24ariel3/SmartInfo/EXTRA/Docs/18650_battery_shield_v8_schematic.pdf

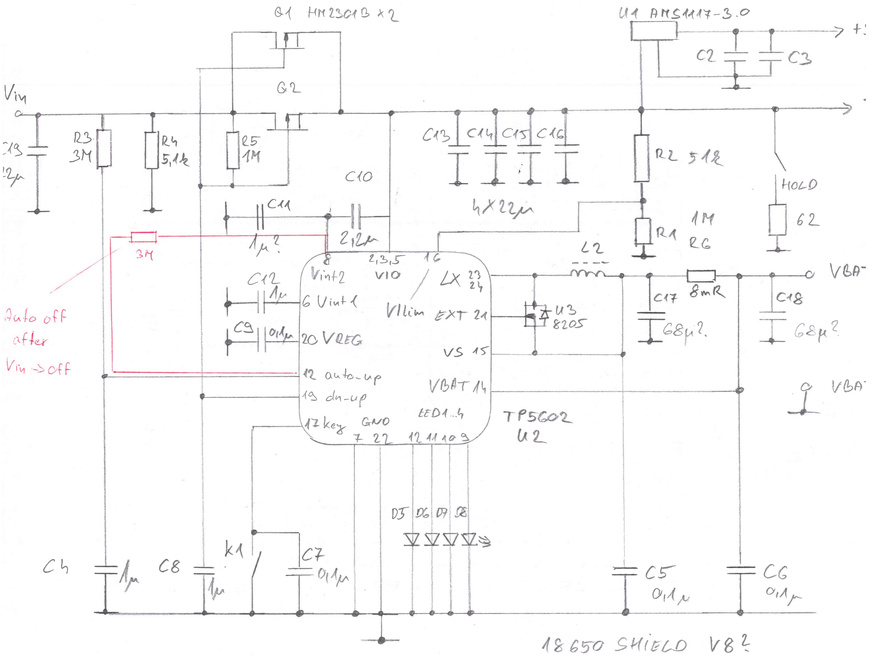
[picture p4: page 1]
