24ariel3/SmartInfo/EXTRA/Docs/18650_sheild.jpg

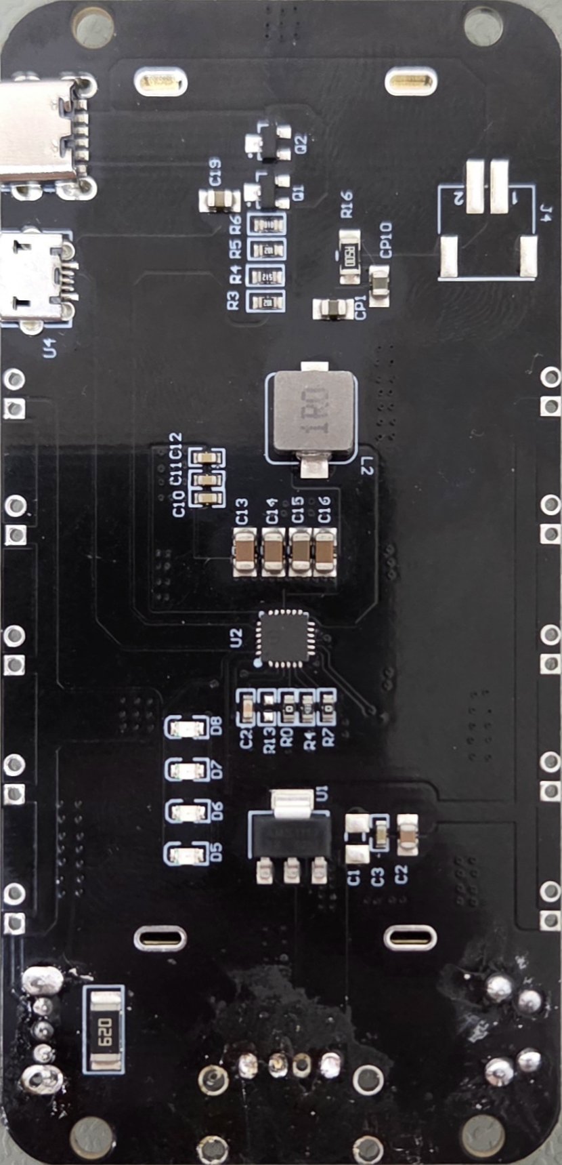
EXTRA/Docs/18650_sheild.jpg
