24ariel3/SmartInfo/EXTRA/Docs/18650_sheild_2.png

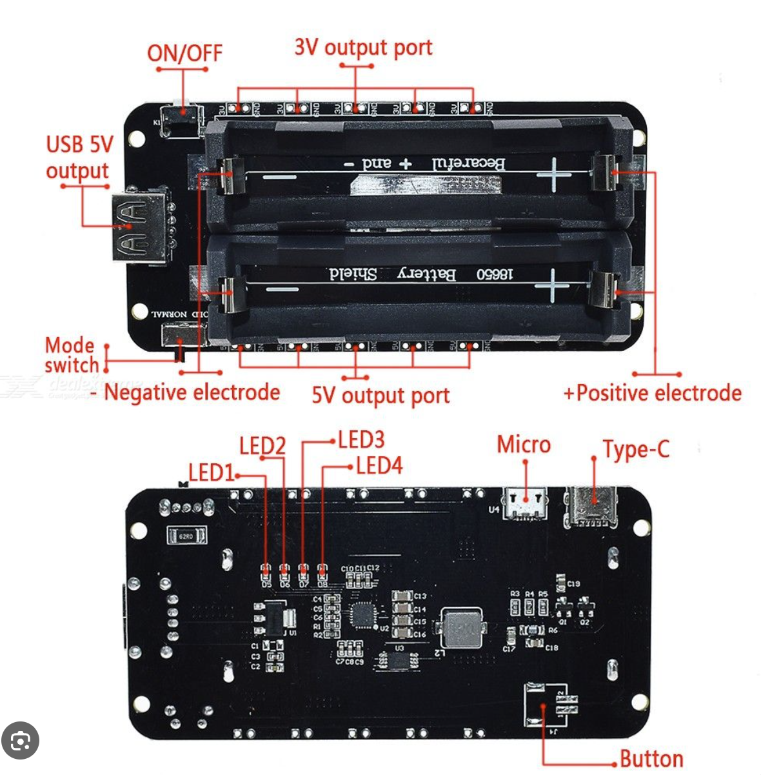
EXTRA/Docs/18650_sheild_2.png
