24ariel3/SmartInfo/EXTRA/Docs/18650_sheild_v3_schematic.jpeg

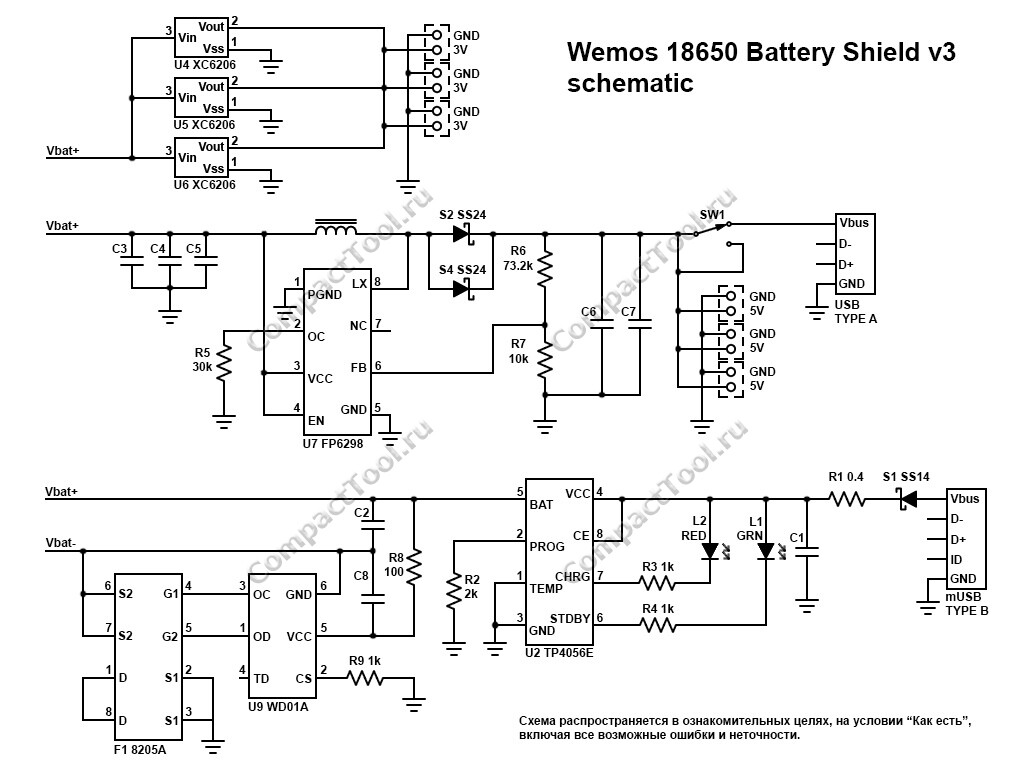
EXTRA/Docs/18650_sheild_v3_schematic.jpeg
