24ariel3/SmartInfo/EXTRA/Docs/BME680_schematics.jpg

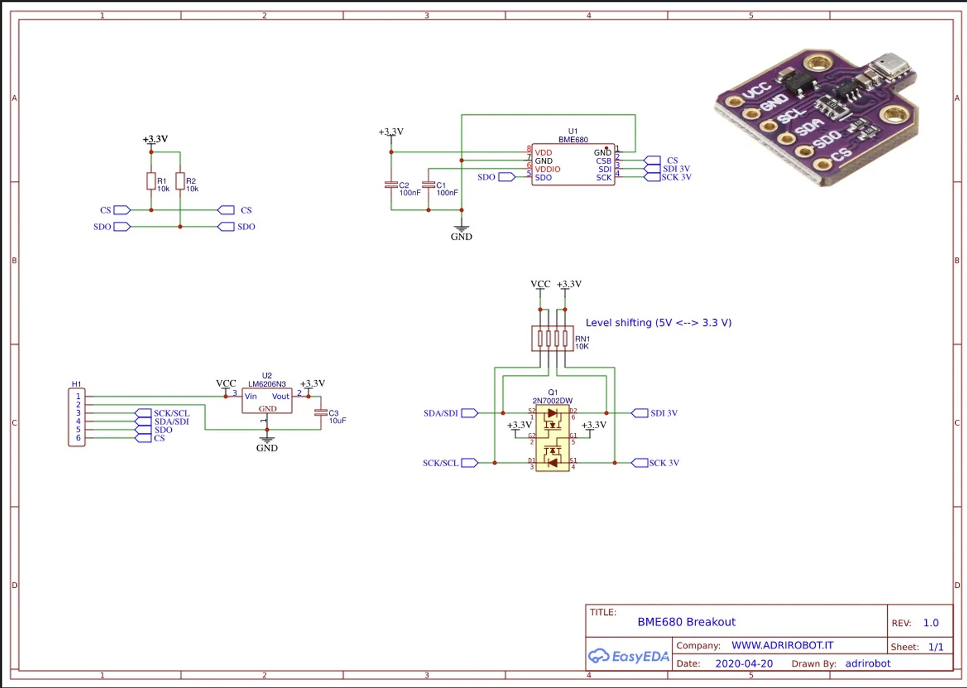
EXTRA/Docs/BME680_schematics.jpg
