24ariel3/SmartInfo/EXTRA/Docs/esp-wroom-32.png

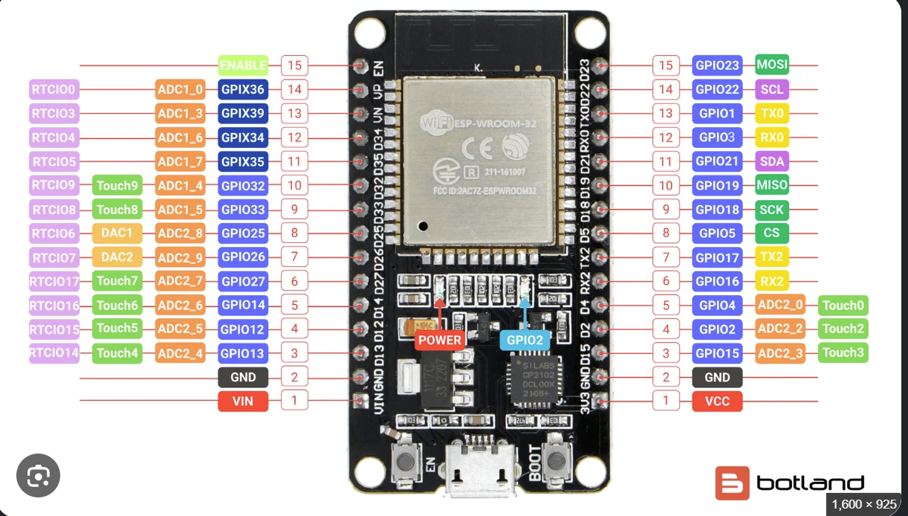
EXTRA/Docs/esp-wroom-32.png
