24ariel3/SmartInfo/EXTRA/Docs/ILI9341_DIM.jpg

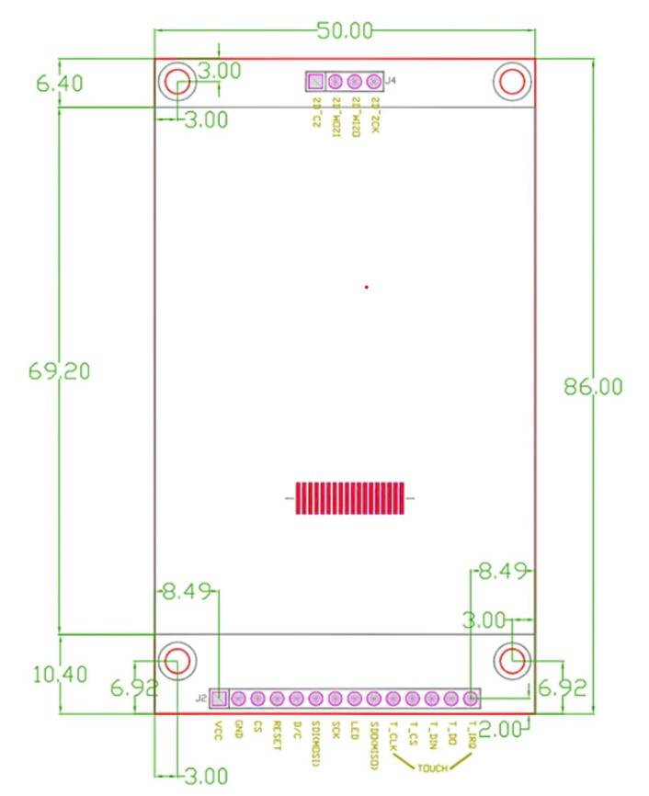
EXTRA/Docs/ILI9341_DIM.jpg
