24ariel3/SmartInfo/EXTRA/Docs/ILI9341_pinout.jpg

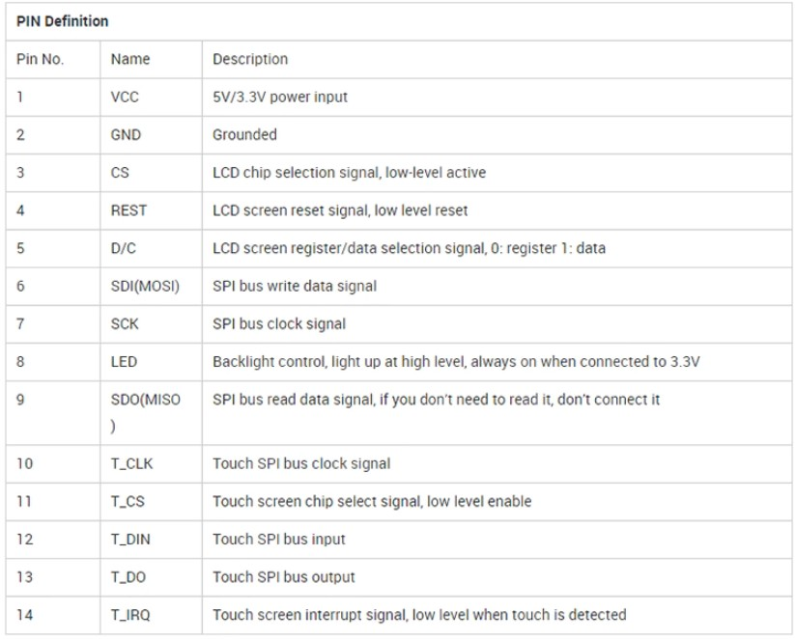
EXTRA/Docs/ILI9341_pinout.jpg
