24ariel3/SmartInfo/EXTRA/Docs/v8_schematic_inspect.png

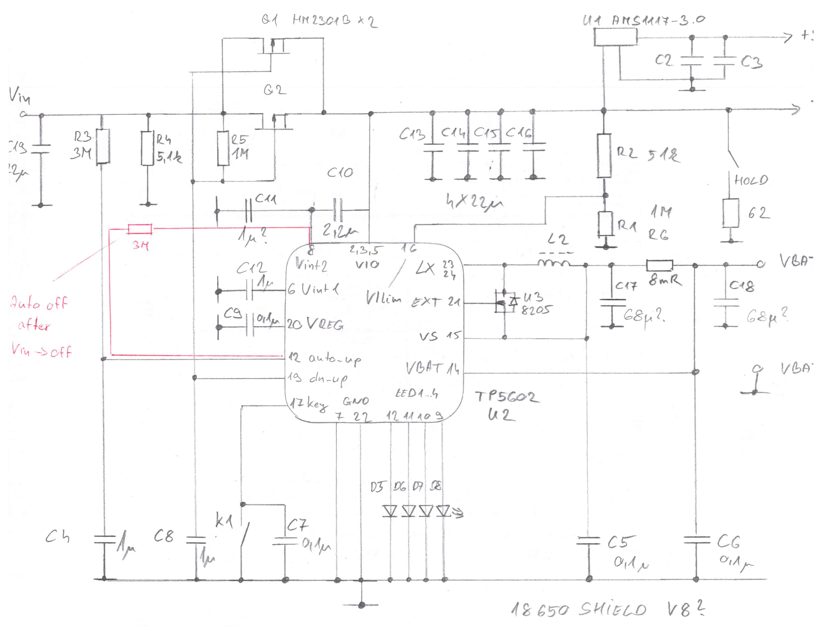
EXTRA/Docs/v8_schematic_inspect.png
