24ariel3/SmartInfo/SquareLine_GUI/SmartInfo_5/cache/thumb_2023752468Gemini_Generated_Image_9l4l2v9l4l2v9l4l.png

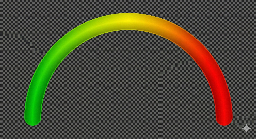
SquareLine_GUI/SmartInfo_5/cache/thumb_2023752468Gemini_Generated_Image_9l4l2v9l4l2v9l4l.png
