24ariel3/SmartInfo/EXTRA/Docs/pinout.xlsx

ESP32 GPIO | ILi9341 | BME680 | Battery
GND | GND | GND
3v3 | VCC | VCC
D22 |  | SCL
D21 |  | SDA
D25 | CS
D26 | RESET
D32 | DC
D23 | MOSI
D18 | SCK
D4 | LED
D19 | MISO
D18 | T_CLK
D34 | T_CS
D23 | T_DIN
D18 | T_DO
D27 | T_IRQ
D34 |  |  | BAT_SENSE
D35 |  |  | CHARGER_SENSE
