24ariel3/SmartInfo/EXTRA/CAD/v3/Assy_18650 Battery Shield V8_R2.SLDPRT

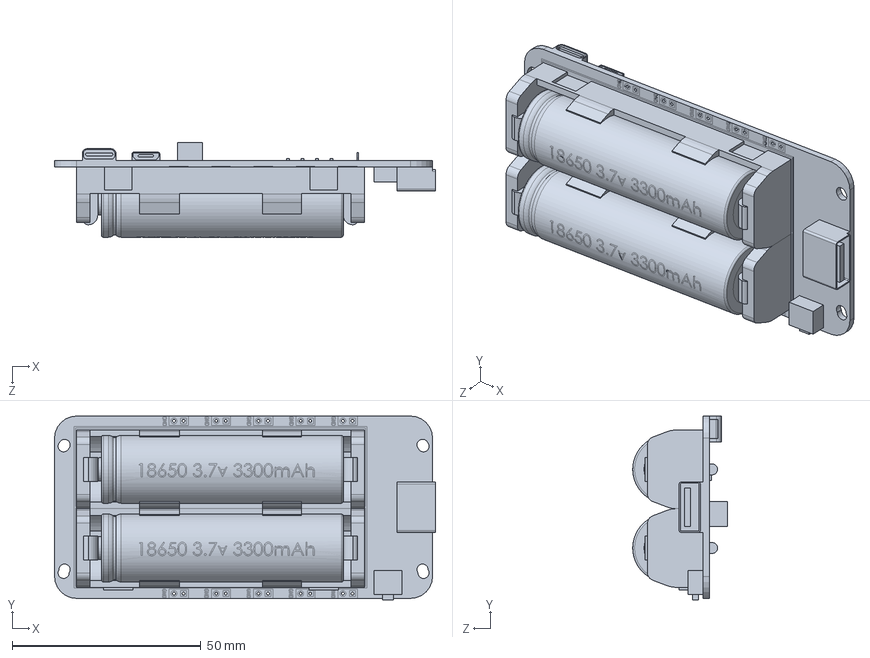
[picture p14: CAD file, 2026-10-31]
EXTRA/CAD/v3/Assy_18650 Battery Shield V8_R2.SLDPRT
100.8 x 48.7 x 25.0 mm
