24ariel3/SmartInfo/EXTRA/CAD/v3/CJMCU-680_2.SLDPRT

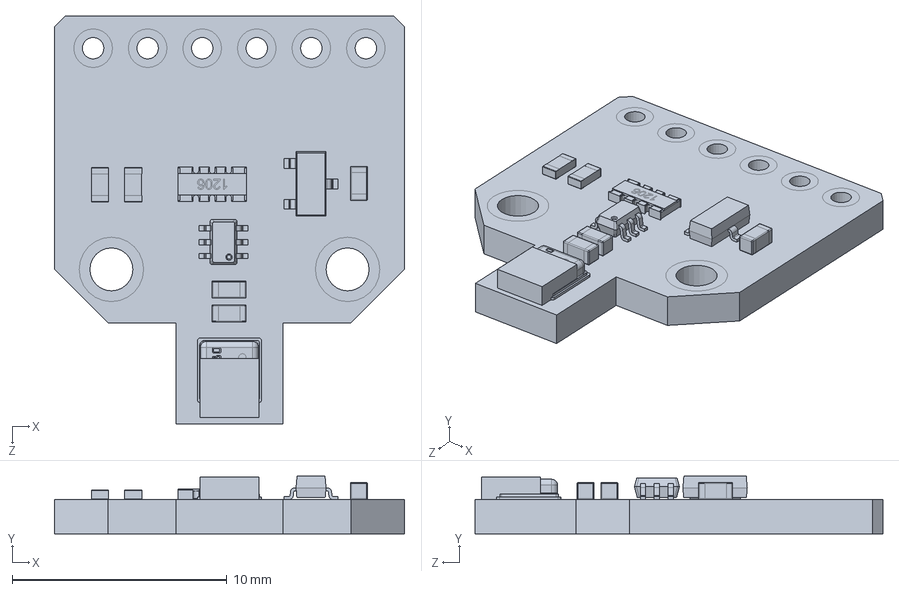
[picture p15: CAD file, 2026-11-01]
EXTRA/CAD/v3/CJMCU-680_2.SLDPRT
16.3 x 2.70 x 19.0 mm
