24ariel3/SmartInfo/EXTRA/CAD/v3/stl/smartinfo_v3_case_5_cover_v2.STL

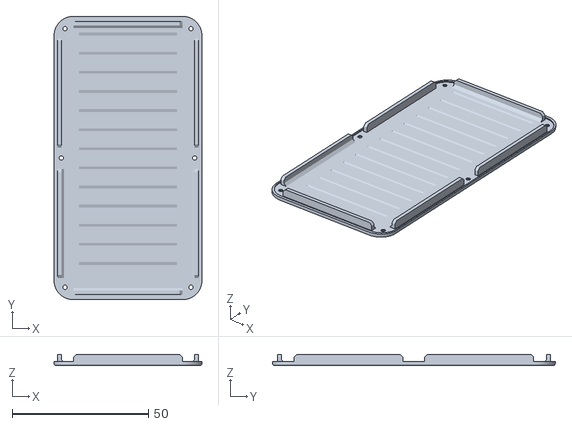
[picture p16: CAD file, 2026-10-31]
EXTRA/CAD/v3/stl/smartinfo_v3_case_5_cover_v2.STL
54.4 x 104.0 x 4.20
