24ariel3/SmartInfo/EXTRA/CAD/v3/smartinfo_v3_case_2_v2.SLDPRT

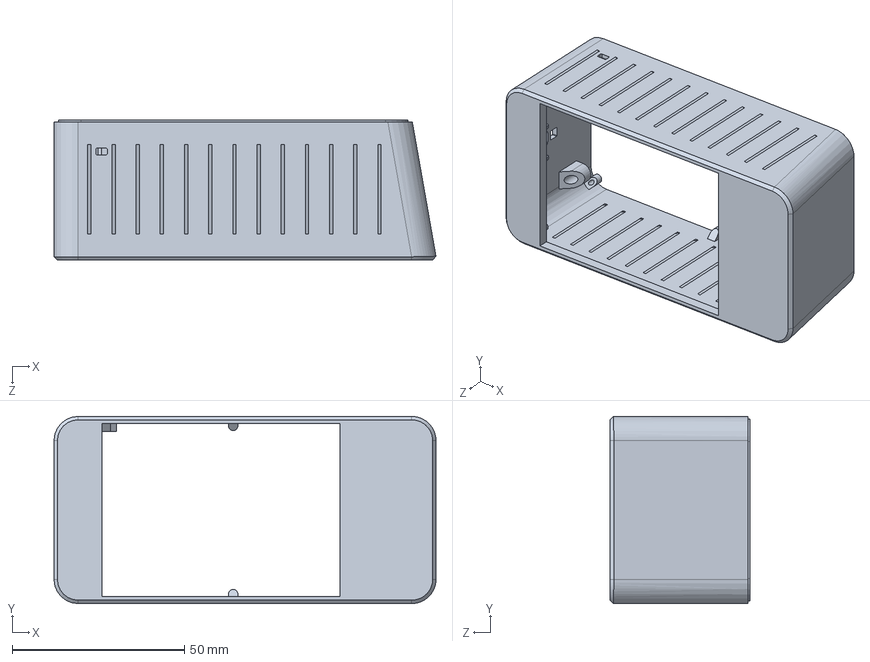
[picture p17: CAD file, 2026-11-01]
EXTRA/CAD/v3/smartinfo_v3_case_2_v2.SLDPRT
111.0 x 54.4 x 40.8 mm
