24ariel3/SmartInfo/EXTRA/CAD/v3/smartinfo_v3_case_7_esp32_mount.SLDPRT

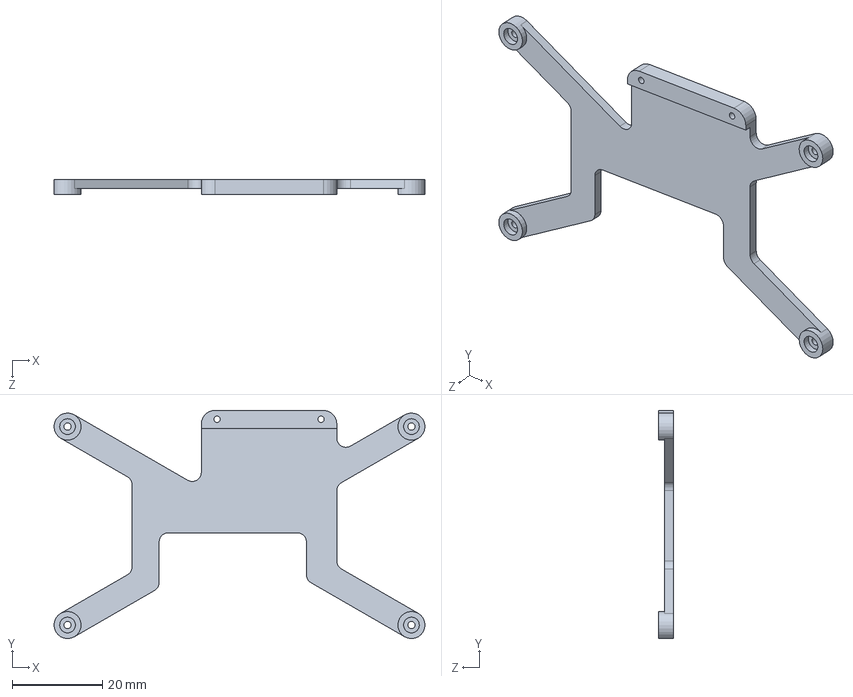
[picture p18: CAD file, 2026-11-01]
EXTRA/CAD/v3/smartinfo_v3_case_7_esp32_mount.SLDPRT
82.1 x 50.5 x 3.37 mm
