24ariel3/SmartInfo/EXTRA/CAD/v3/smartinfo_v3_case_4_cap.SLDPRT

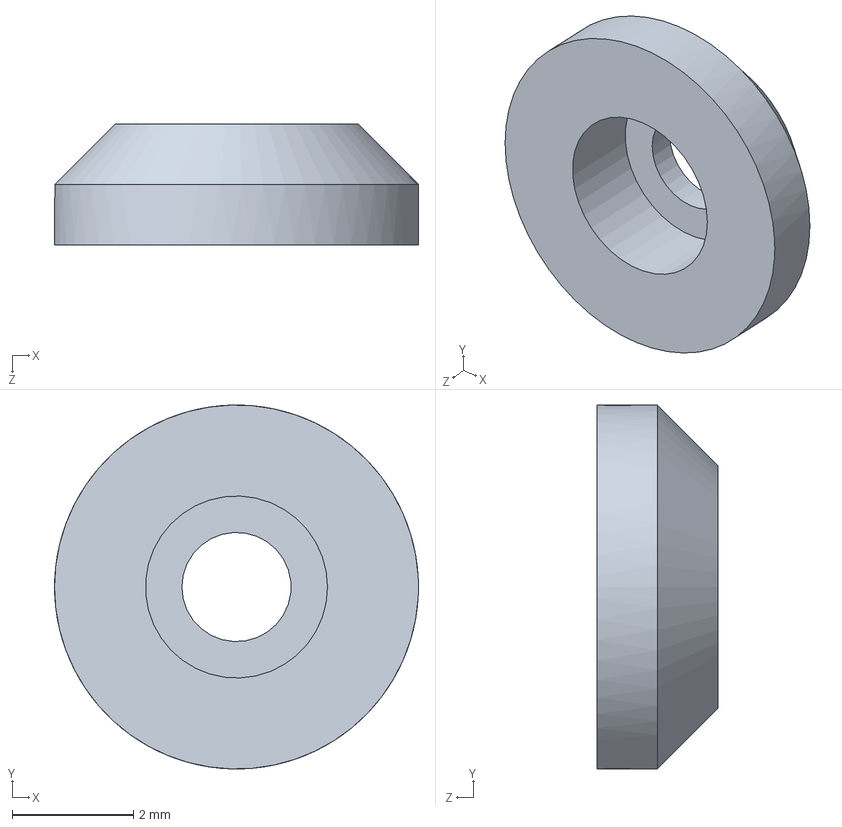
[picture p19: CAD file, 2026-10-31]
EXTRA/CAD/v3/smartinfo_v3_case_4_cap.SLDPRT
6.00 x 6.00 x 2.00 mm
