24ariel3/SmartInfo/EXTRA/CAD/v3/smartinfo_v3_case_9_button.SLDPRT

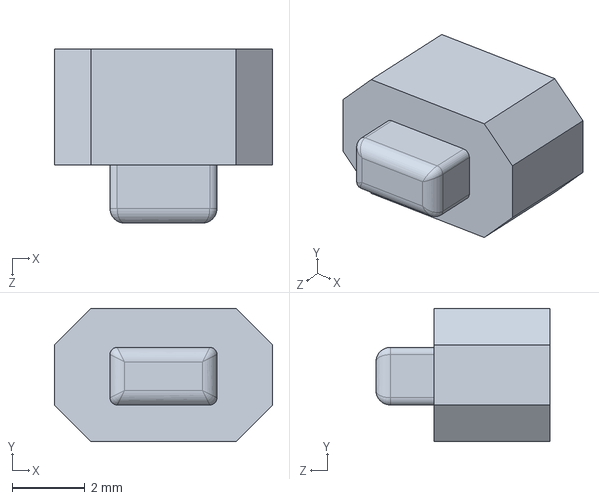
[picture p20: CAD file, 2026-10-31]
EXTRA/CAD/v3/smartinfo_v3_case_9_button.SLDPRT
6.00 x 3.66 x 4.80 mm
