24ariel3/SmartInfo/EXTRA/CAD/v3/smartinfo_v3_case_1.SLDPRT

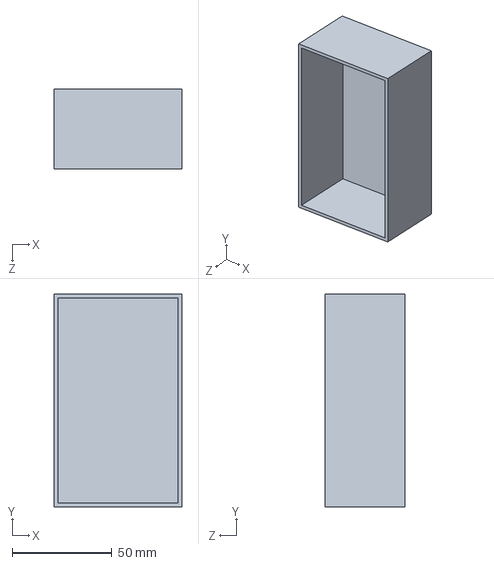
[picture p21: CAD file, 2026-10-31]
EXTRA/CAD/v3/smartinfo_v3_case_1.SLDPRT
64.0 x 106.8 x 40.0 mm
