24ariel3/SmartInfo/EXTRA/CAD/v3/smartinfo_v3_case_8_esp32_mount_spacer.SLDPRT

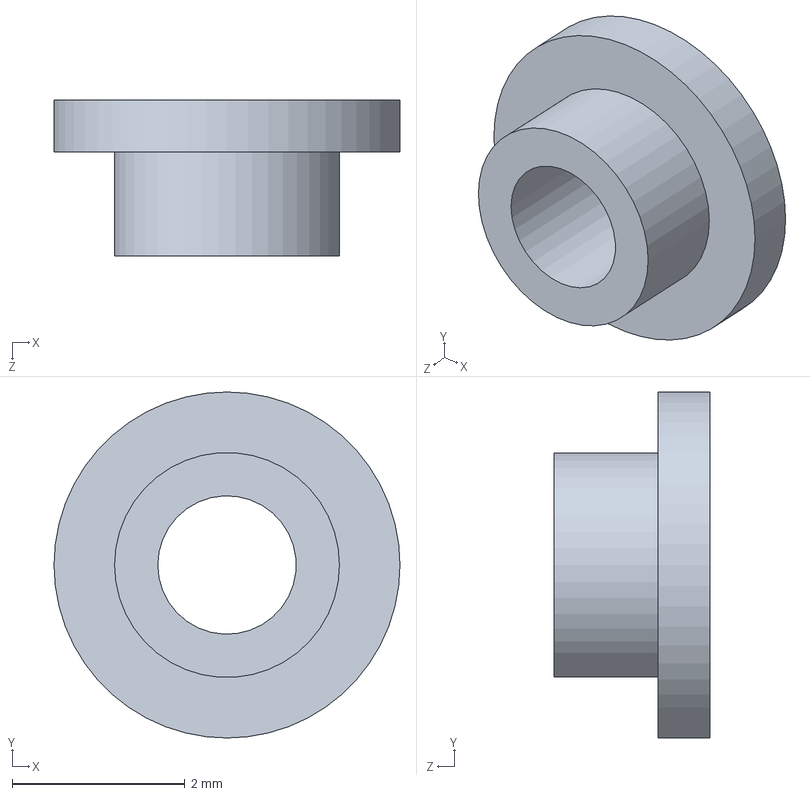
[picture p22: CAD file, 2026-10-31]
EXTRA/CAD/v3/smartinfo_v3_case_8_esp32_mount_spacer.SLDPRT
4.00 x 4.00 x 1.80 mm
