24ariel3/SmartInfo/EXTRA/CAD/v3/smartinfo_v3_case_2.SLDPRT

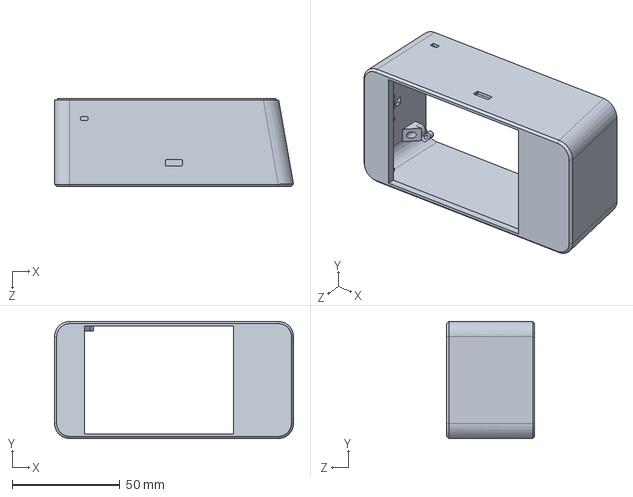
[picture p24: CAD file, 2026-10-31]
EXTRA/CAD/v3/smartinfo_v3_case_2.SLDPRT
111.0 x 54.4 x 40.8 mm
