24ariel3/SmartInfo/EXTRA/CAD/v3/smartinfo_v3_case_6_bme680_cover.SLDPRT

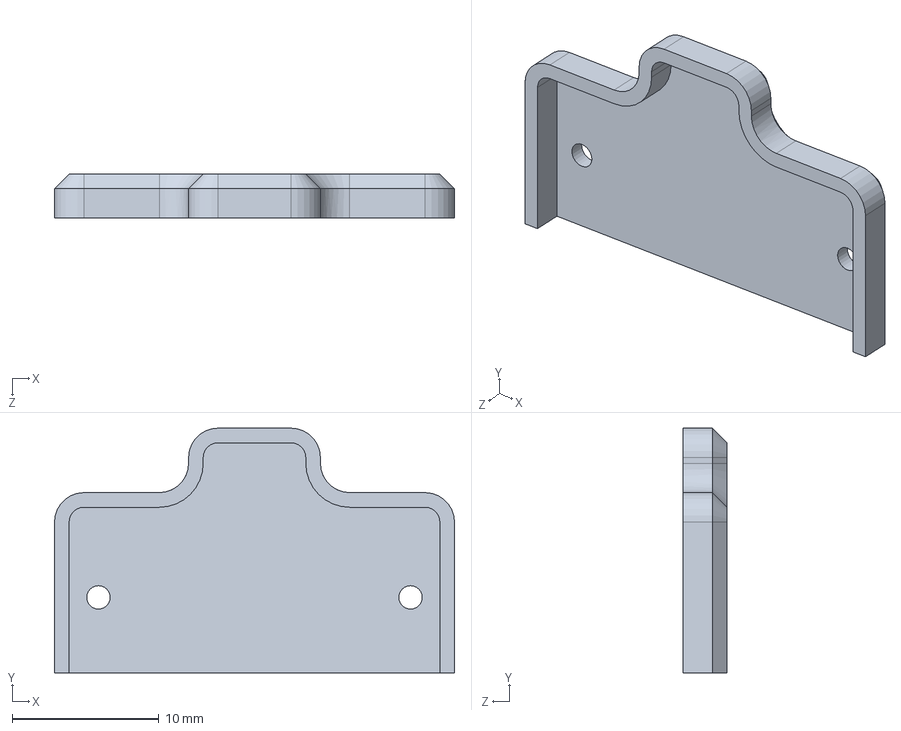
[picture p25: CAD file, 2026-10-31]
EXTRA/CAD/v3/smartinfo_v3_case_6_bme680_cover.SLDPRT
27.3 x 16.7 x 3.00 mm
