24ariel3/SmartInfo/EXTRA/CAD/v1/bme680.SLDPRT

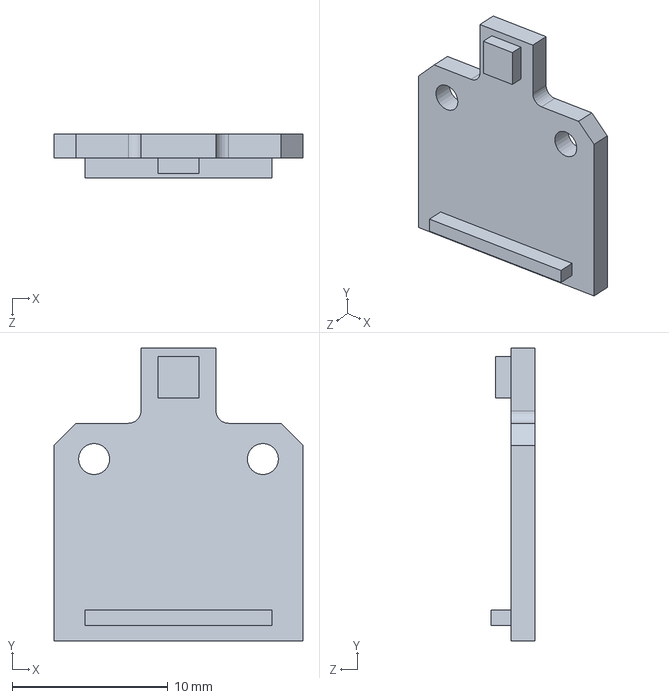
[picture p26: CAD file, 2026-10-31, an earlier design]
EXTRA/CAD/v1/bme680.SLDPRT
16.0 x 18.8 x 2.85 mm
