24ariel3/SmartInfo/EXTRA/CAD/v1/STL/back_cover.SLDPRT

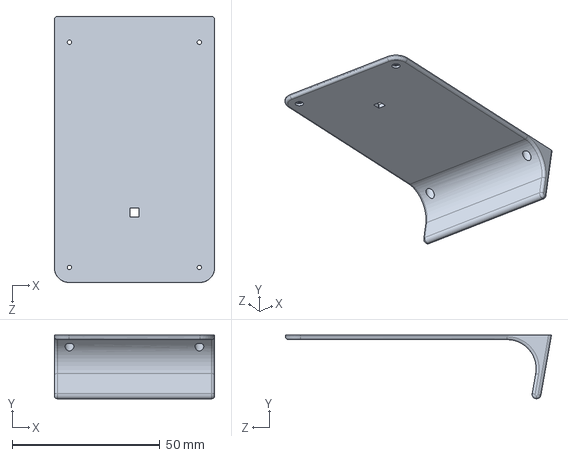
[picture p27: CAD file, 2026-10-31, an earlier design]
EXTRA/CAD/v1/STL/back_cover.SLDPRT
54.2 x 21.5 x 89.9 mm
