24ariel3/SmartInfo/EXTRA/CAD/v3/smartinfo3_assm.SLDASM

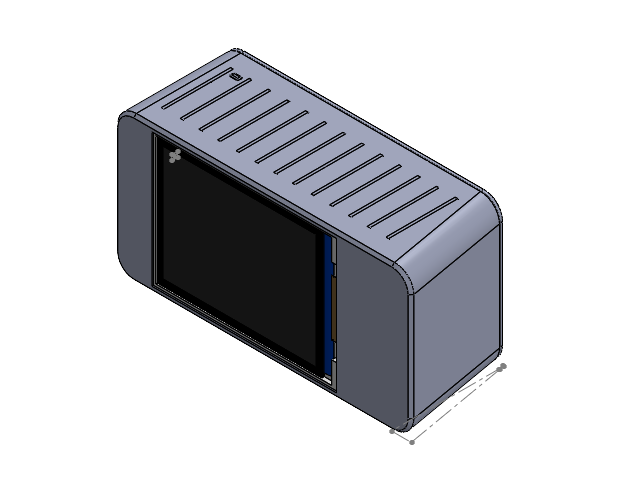
[picture p28: CAD file, 2026-11-01]
EXTRA/CAD/v3/smartinfo3_assm.SLDASM
Assy_18650 Battery Shield V8_R2
esp32
2.8 LCD TFT Module - Without Glass.stp
5035000993.stp
0603 Resistor.stp x 6
0603 Capacitor.stp x 2
SOT23-3.stp x 2
2.8in TFT(Without Glass)- Tucked Cable.stp
smartinfo_v3_case_2_v2
CJMCU-680_2
smartinfo_v3_case_5_cover
smartinfo_v3_case_6_bme680_cover
smartinfo_v3_case_7_esp32_mount
smartinfo_v3_case_8_esp32_mount_spacer x 2
smartinfo_v3_case_9_button
