24ariel3/SmartInfo/EXTRA/CAD/v1/Assem3.SLDASM

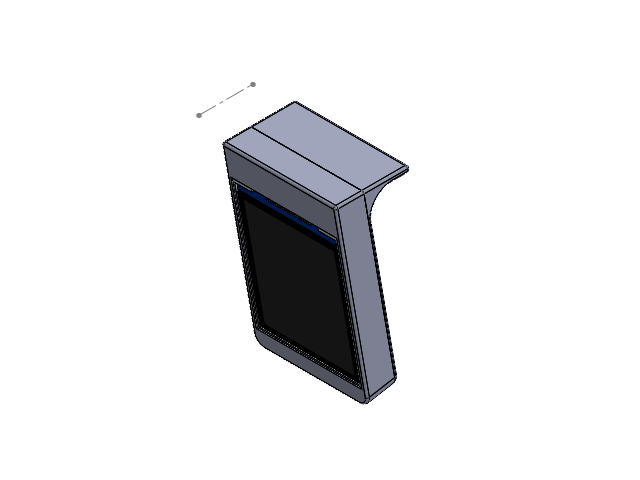
[picture p29: CAD file, 2026-10-31, an earlier design]
EXTRA/CAD/v1/Assem3.SLDASM
2.8 LCD TFT Module - Without Glass.stp
5035000993.stp
0603 Resistor.stp x 6
0603 Capacitor.stp x 2
SOT23-3.stp x 2
2.8in TFT(Without Glass)- Tucked Cable.stp
tft_cover
esp32
back_cover
bme680
spacers x 2
