24ariel3/SmartInfo/(list of files, cad)

Other CAD files:
EXTRA/CAD/v3/smartinfo_v3_case_5_cover.SLDPRT
EXTRA/CAD/v1/STL/back_cover.STL
EXTRA/CAD/v1/STL/spacers.STL
EXTRA/CAD/v1/STL/tft_cover.SLDPRT
EXTRA/CAD/v1/STL/tft_cover.STL
EXTRA/CAD/v1/back_cover.SLDPRT
EXTRA/CAD/v1/spacers.SLDPRT
EXTRA/CAD/v1/tft_cover.SLDPRT
EXTRA/CAD/v2/back_cover.SLDPRT
EXTRA/CAD/v2/esp32.SLDPRT
EXTRA/CAD/v2/spacers.SLDPRT
EXTRA/CAD/v2/tft_cover.SLDPRT
EXTRA/CAD/v3/stl/smartinfo_v3_case_2.STL
EXTRA/CAD/v3/stl/smartinfo_v3_case_2_v2.STL
EXTRA/CAD/v3/stl/smartinfo_v3_case_5_cover.STL
EXTRA/CAD/v3/stl/smartinfo_v3_case_6_bme680_cover.STL
EXTRA/CAD/v3/stl/smartinfo_v3_case_7_esp32_mount.STL
EXTRA/CAD/v3/stl/smartinfo_v3_case_8_esp32_mount_spacer.STL
EXTRA/CAD/v3/stl/smartinfo_v3_case_9_button.STL
