24ariel3/SmartInfo/EXTRA/Docs/Battery/Test of Panasonic NCR18650B 3400mAh (Green).pdf

# Panasonic NCR18650B 3400mAh (Green)

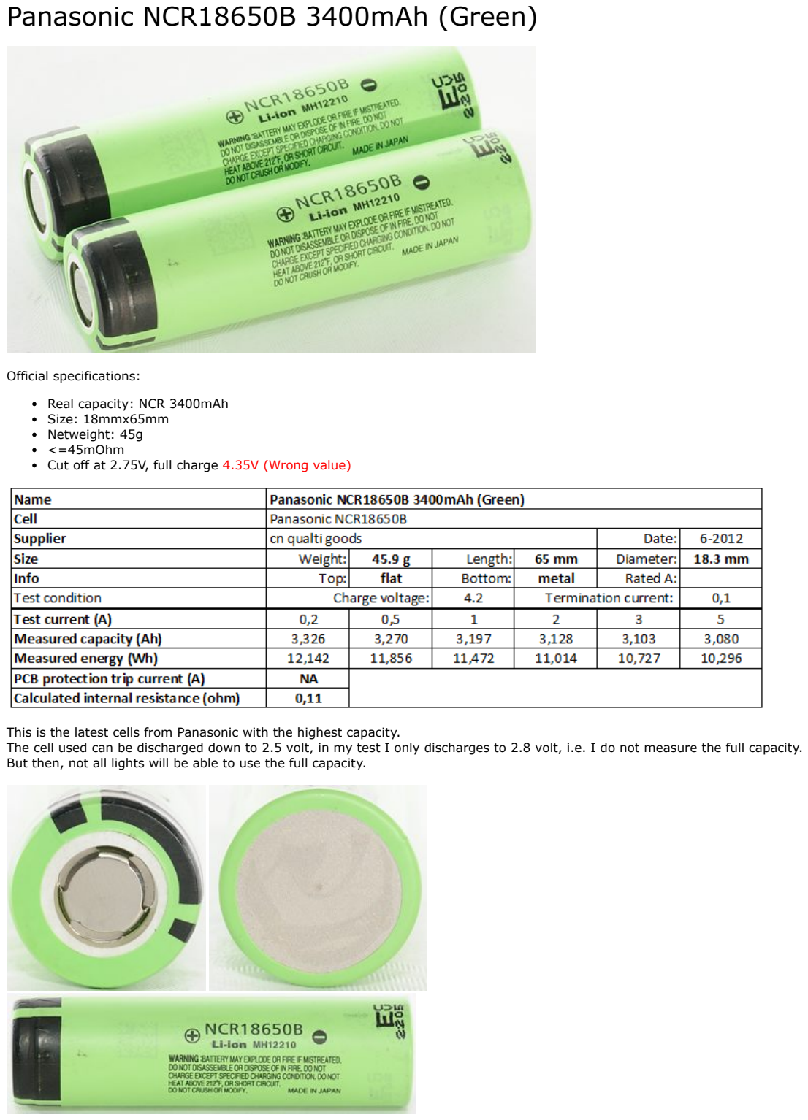
[picture p31: page 1]

Official specifications:

Real capacity: NCR 3400mAh Size: 18mmx65mm
Netweight: 45g
<=45mOhm
Cut off at 2.75V, full charge 4.35V (Wrong value)

This is the latest cells from Panasonic with the highest capacity.
The cell used can be discharged down to 2.5 volt, in my test I only discharges to 2.8 volt, i.e. I do not measure the full capacity. But then, not all lights will be able to use the full capacity.

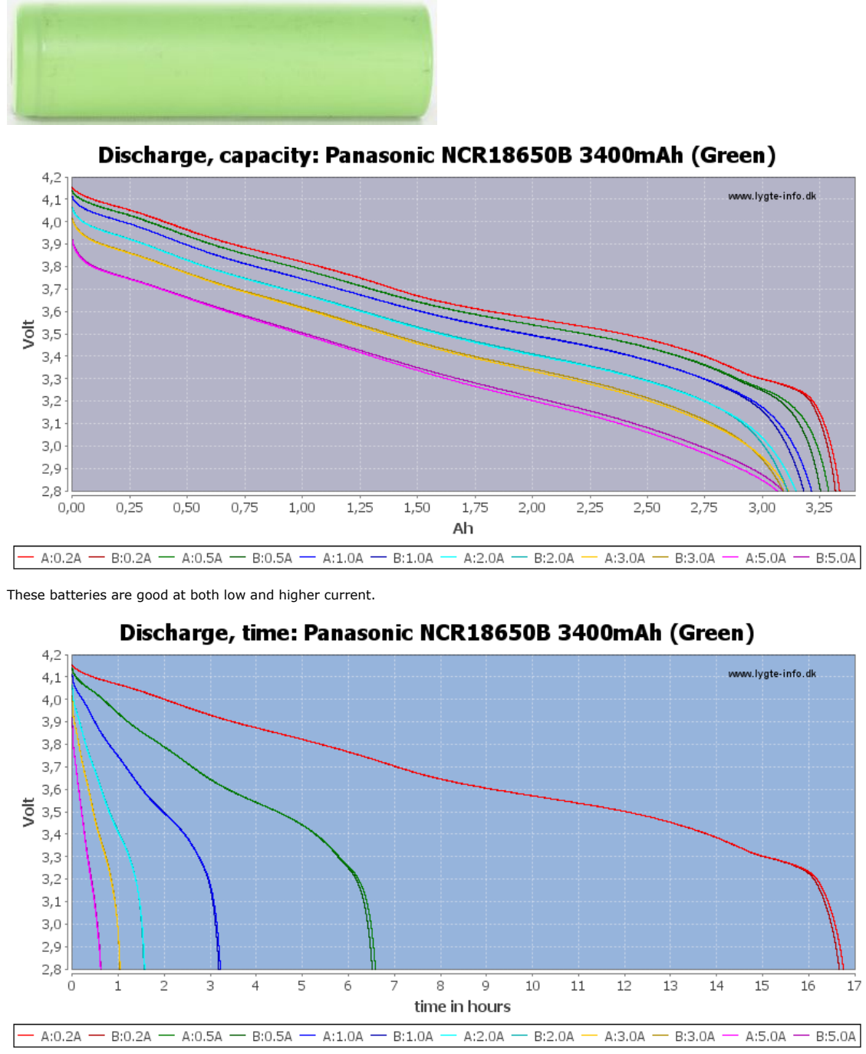
[picture p32: page 2]

These batteries are good at both low and higher current.

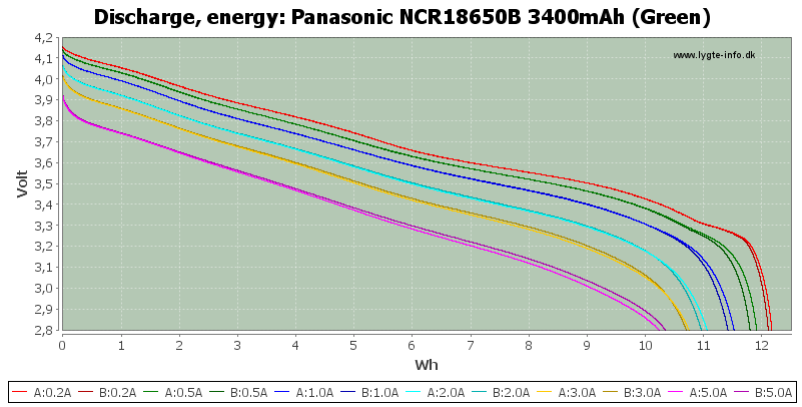
[picture p33: figure]

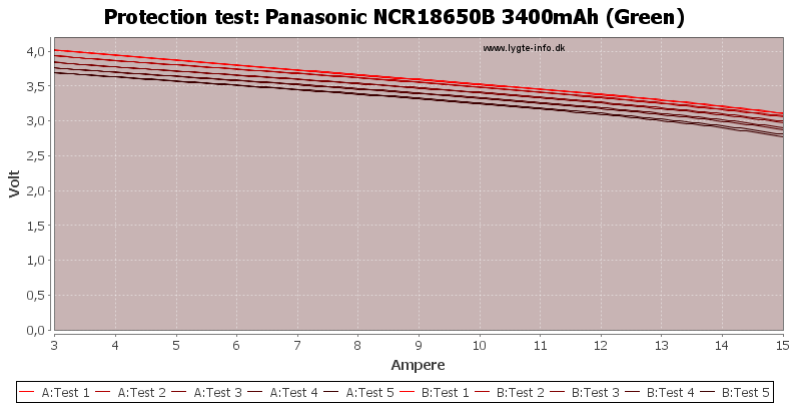
[picture p34: figure]

These are unprotected cell, i.e. the protection will not trip.

# Conclusion

This is genuine Panasonic cells and cannot get any other rathing than very good, but remember that they are unprotected!

# Notes and links

How is the test done and how to read the charts (https://lygte-info.dk/info/Batteries2012Info%20UK.html) How is a protected LiIon battery constructed (https://lygte-info.dk/info/battery%20protection%20UK.html) More about button top and flat top batteries (https://lygte-info.dk/info/Battery%20button%20or%20flat%20UK.html)
