24ariel3/SmartInfo/EXTRA/Docs/LCD/MSP2401_Size.pdf

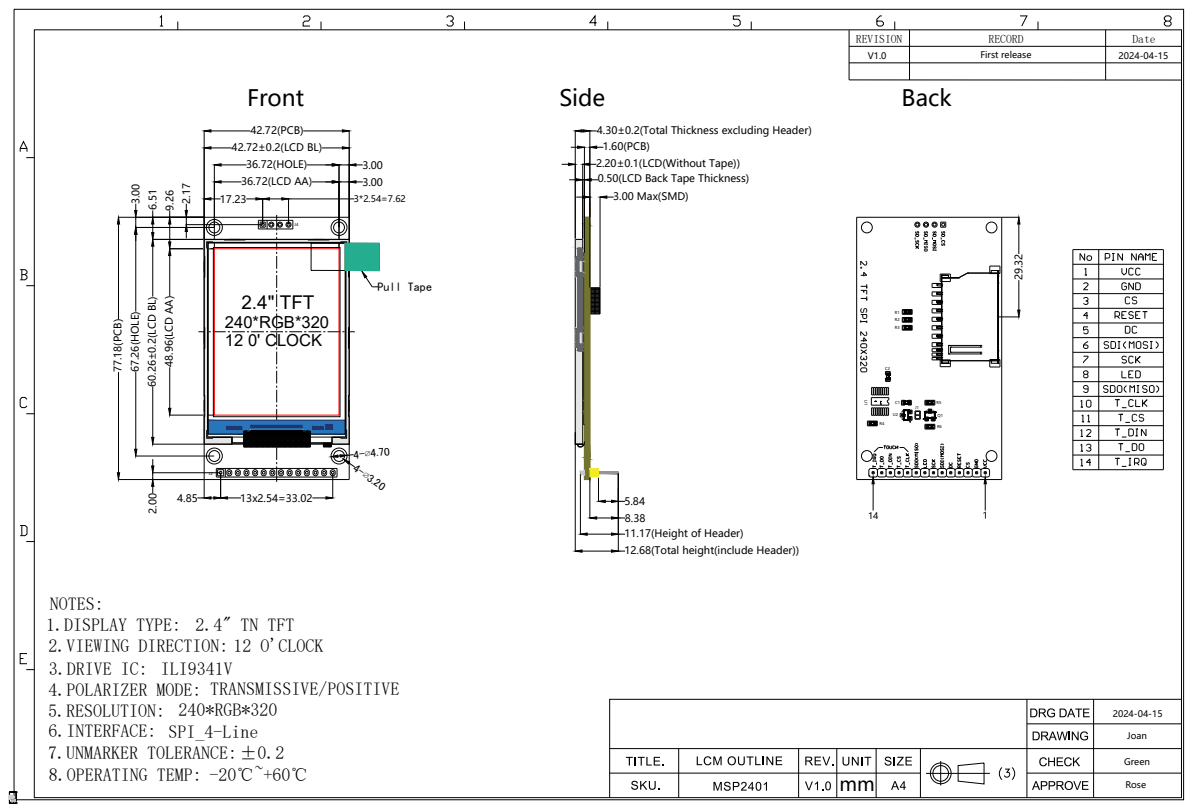
[picture p35: page 1]

REVISION | RECORD | Date
V1.0 | First release | 2024-04-15

4.30±0.2(Total Thickness excluding Header)
1.60(PCB)
2.20±0.1(LCD(Without Tape))
0.50(LCD Back Tape Thickness)
3.00 Max(SMD)

DRG DATE | | 2024-04-15

DRAWING | | Joan

CHECK | Green
