24ariel3/SmartInfo/components/bsec_bme680/src/bsec_config.c

#include "bsec_config.h"

/*
 * [USER ACTION REQUIRED]
 * 1. Open the BSEC library folder you downloaded.
 * 2. Go to: config/generic_33v_3s_28d/
 * 3. Open the file: bsec_iaq.c (or bsec_iaq.h / bsec_config.c)
 * 4. Copy the entire 'bsec_config_iaq' array content.
 * 5. Paste it below to replace the placeholder.
 *
 * NOTE: The size 492 is typical for BSEC 2.x generic configs.
 * If your array is different, update the array content.
 */

const uint8_t bsec_config_iaq[492] = {
    0,   1,   6,   2,   61,  0,   0,   0,   0,   0,   0,   0,   212, 1,   0,
    0,   56,  0,   1,   0,   0,   168, 19,  73,  64,  49,  119, 76,  0,   192,
    40,  72,  0,   192, 40,  72,  10,  0,   3,   0,   0,   0,   96,  64,  23,
    183, 209, 56,  43,  24,  149, 60,  140, 74,  106, 188, 43,  24,  149, 60,
    216, 129, 243, 190, 151, 255, 80,  190, 216, 129, 243, 190, 8,   0,   2,
    0,   0,   0,   72,  66,  16,  0,   3,   0,   10,  215, 163, 60,  10,  215,
    35,  59,  10,  215, 35,  59,  13,  0,   5,   0,   0,   0,   0,   0,   100,
    254, 131, 137, 87,  88,  0,   9,   0,   229, 208, 34,  62,  0,   0,   0,
    0,   0,   0,   0,   0,   218, 27,  156, 62,  225, 11,  67,  64,  0,   0,
    160, 64,  0,   0,   0,   0,   0,   0,   0,   0,   94,  75,  72,  189, 93,
    254, 159, 64,  66,  62,  160, 191, 0,   0,   0,   0,   0,   0,   0,   0,
    33,  31,  180, 190, 138, 176, 97,  64,  65,  241, 99,  190, 0,   0,   0,
    0,   0,   0,   0,   0,   167, 121, 71,  61,  165, 189, 41,  192, 184, 30,
    189, 64,  12,  0,   10,  0,   0,   0,   0,   0,   0,   0,   0,   0,   19,
    1,   254, 0,   2,   1,   5,   48,  117, 100, 0,   44,  1,   112, 23,  151,
    7,   132, 3,   197, 0,   92,  4,   144, 1,   64,  1,   64,  1,   144, 1,
    48,  117, 48,  117, 48,  117, 48,  117, 100, 0,   100, 0,   100, 0,   48,
    117, 48,  117, 48,  117, 100, 0,   100, 0,   48,  117, 48,  117, 100, 0,
    100, 0,   100, 0,   100, 0,   48,  117, 48,  117, 48,  117, 100, 0,   100,
    0,   100, 0,   48,  117, 48,  117, 100, 0,   100, 0,   44,  1,   44,  1,
    44,  1,   44,  1,   44,  1,   44,  1,   44,  1,   44,  1,   44,  1,   44,
    1,   44,  1,   44,  1,   44,  1,   44,  1,   112, 23,  112, 23,  112, 23,
    112, 23,  8,   7,   8,   7,   8,   7,   8,   7,   112, 23,  112, 23,  112,
    23,  112, 23,  112, 23,  112, 23,  255, 255, 255, 255, 255, 255, 255, 255,
    112, 23,  112, 23,  112, 23,  112, 23,  255, 255, 255, 255, 220, 5,   220,
    5,   255, 255, 255, 255, 255, 255, 255, 255, 255, 255, 255, 255, 220, 5,
    220, 5,   220, 5,   255, 255, 255, 255, 255, 255, 255, 255, 255, 255, 255,
    255, 255, 255, 255, 255, 255, 255, 255, 255, 255, 255, 255, 255, 255, 255,
    255, 255, 255, 255, 255, 255, 255, 255, 255, 255, 255, 255, 255, 255, 255,
    255, 44,  1,   0,   5,   10,  5,   0,   2,   0,   10,  0,   30,  0,   5,
    0,   5,   0,   5,   0,   5,   0,   5,   0,   5,   0,   64,  1,   100, 0,
    100, 0,   100, 0,   200, 0,   200, 0,   200, 0,   64,  1,   64,  1,   64,
    1,   10,  0,   0,   0,   0,   0,   0,   95,  79,  0,   0};

const int bsec_config_iaq_len = sizeof(bsec_config_iaq);
