24ariel3/SmartInfo/(commit log)

2026-10-22 battery sense support
2026-10-24 Add OTA updates and battery sensing Add authenticated OTA firmware updates, battery monitoring, wiring documentation, and related UI and hardware assets.
2026-10-24 battery level ui update
2026-10-24 - Battery reporting: Replaces the linear voltage-to-percentage formula with a piecewise lookup table and updates the API comment. - Memory and network reliability: Uses smaller display buffers with a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
2026-10-26 Battery reading improvements Charger detection
2026-10-26 Reduce power use with scheduled Wi-Fi and idle screen dimming
    - Dim the backlight after 60 seconds without touch, capped at 20%,
    and restore the selected brightness on interaction.
    - Run stock, weather, and NTP updates sequentially in one network worker.
    - Refresh stocks every five minutes and weather/time hourly.
    - Stop Wi-Fi when unused, with holds for startup, Network settings,
    scans, synchronization, and OTA uploads.
    - Replace background fetch loops with explicit refresh APIs and
    update UI callbacks to request synchronization.
    - Replace the 2 ms LVGL tick timer with esp_timer-based timing and
    enforce a minimum FreeRTOS task delay.
    - Fix stale Wi-Fi connection event bits during re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
2026-10-28 Battery power optimizations
2026-10-29 Reduce power use with minute-aligned updates and idle light sleep
    - Align clock and sensor display updates to minute boundaries
    - Enable frequency scaling and tickless idle light sleep
    - Preserve backlight PWM and GPIO27 touch wakeup
    - Document power-saving behavior and recovery
2026-10-31 Reduce idle power use and add enclosure design resources
    - Schedule stock refreshes during US market hours with New York DST handling
    - Use hourly weather/time windows outside market hours
    - Reduce idle LVGL activity while preserving immediate touch wakeup
    - Remove the stock-request delay and reuse HTTPS connections
    - Refresh exported dashboard layouts
    - Add power-efficiency regression checks and battery SOC plotting
    - Document battery runtime history and the successful OTA update
    - Add enclosure CAD/STL files, hardware references and screen images
2026-11-01 cad fix
2026-11-04 Add charger-aware shield keep-alive avoiding HOLD mode and 62Khom resistor power waste and silence backlight PWM
2026-11-04 Reorganize README and document battery efficiency history
    Separate wiring, monitoring, power efficiency, calibration, updates and testing. Document implemented software and hardware measures with reported battery runtimes, preserve UI images and the PCB diagram, and correct the touch wiring reference.
2026-11-07 Stabilize battery estimates and update sensor compensation
    - Derive usable-energy percentage from the NCR18650B reference curve
    - Smooth percentage readings with a median filter and EMA
    - Read the firmware LUT in plotting tools and extend regression checks
    - Reduce BSEC heat compensation from 3.5 C to 1.5 C after eliminating
    the 62-ohm HOLD resistor heat source through NORMAL-mode operation
    - Document battery estimation and add battery/LCD references
